samshuanlin/ME210_FinalProject/code/test/README.md

For people who are more familiar with the Arduino IDE, you can store the .ino files here.
