samshuanlin/ME210_FinalProject/schematic/core_mcu.kicad_sch

## KiCad design schematic/core_mcu.kicad_sch (2025-03-10)

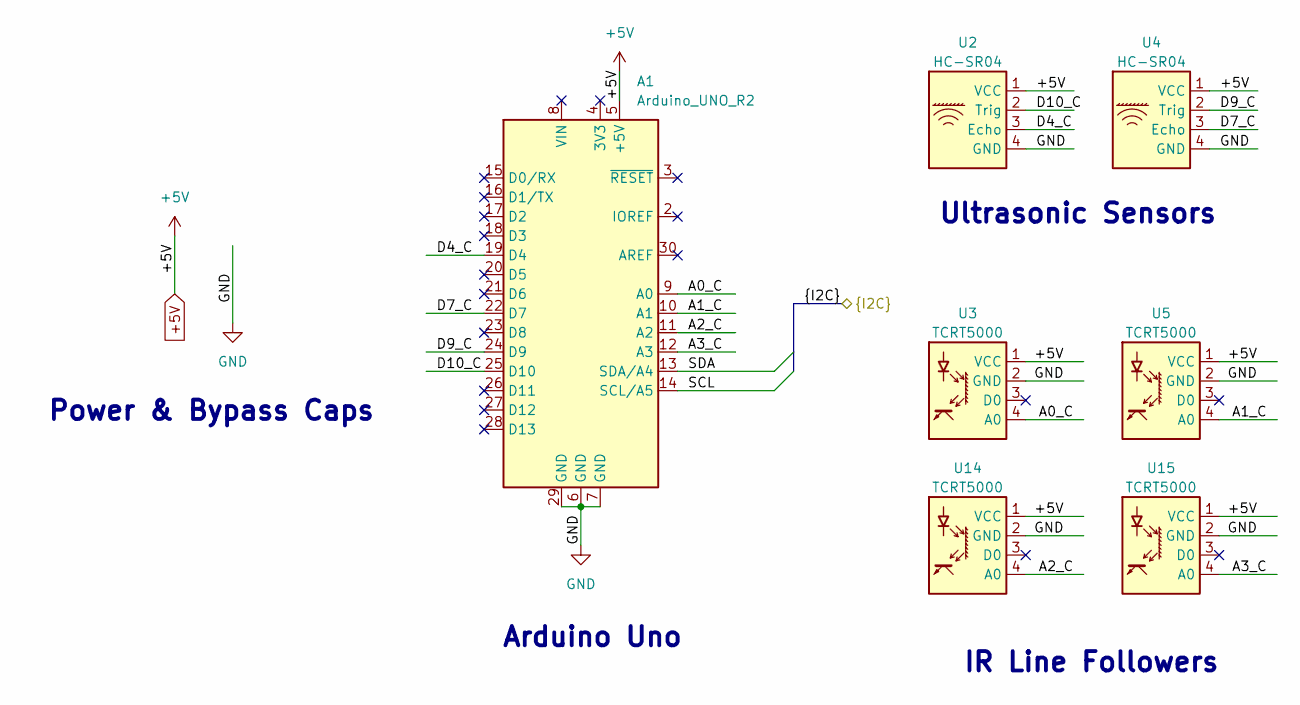
[picture p1: schematic core_mcu.kicad_sch]

Parts:
A1: Arduino_UNO_R2
U2, U4: HC-SR04
U3, U5, U14, U15: TCRT5000

Connections:
+5V: A1.5 (+5V), U2.1 (VCC), U3.1 (VCC), U4.1 (VCC), U5.1 (VCC), U14.1 (VCC), U15.1 (VCC)
A0_C: A1.9 (A0), U3.4 (A0)
A1_C: A1.10 (A1), U5.4 (A0)
A2_C: A1.11 (A2), U14.4 (A0)
A3_C: A1.12 (A3), U15.4 (A0)
D4_C: A1.19 (D4), U2.3 (Echo)
D7_C: A1.22 (D7), U4.3 (Echo)
D9_C: A1.24 (D9), U4.2 (Trig)
D10_C: A1.25 (D10), U2.2 (Trig)
GND: A1.6 (GND), A1.7 (GND), A1.29 (GND), U2.4 (GND), U3.2 (GND), U4.4 (GND), U5.2 (GND), U14.2 (GND), U15.2 (GND)
SCL: A1.14 (SCL/A5)
SDA: A1.13 (SDA/A4)

Notes on the sheet:
IR Line Followers
Ultrasonic Sensors
Power & Bypass Caps
Arduino Uno
