samshuanlin/ME210_FinalProject/schematic/master_mcu.kicad_sch

## KiCad design schematic/master_mcu.kicad_sch (2025-03-10)

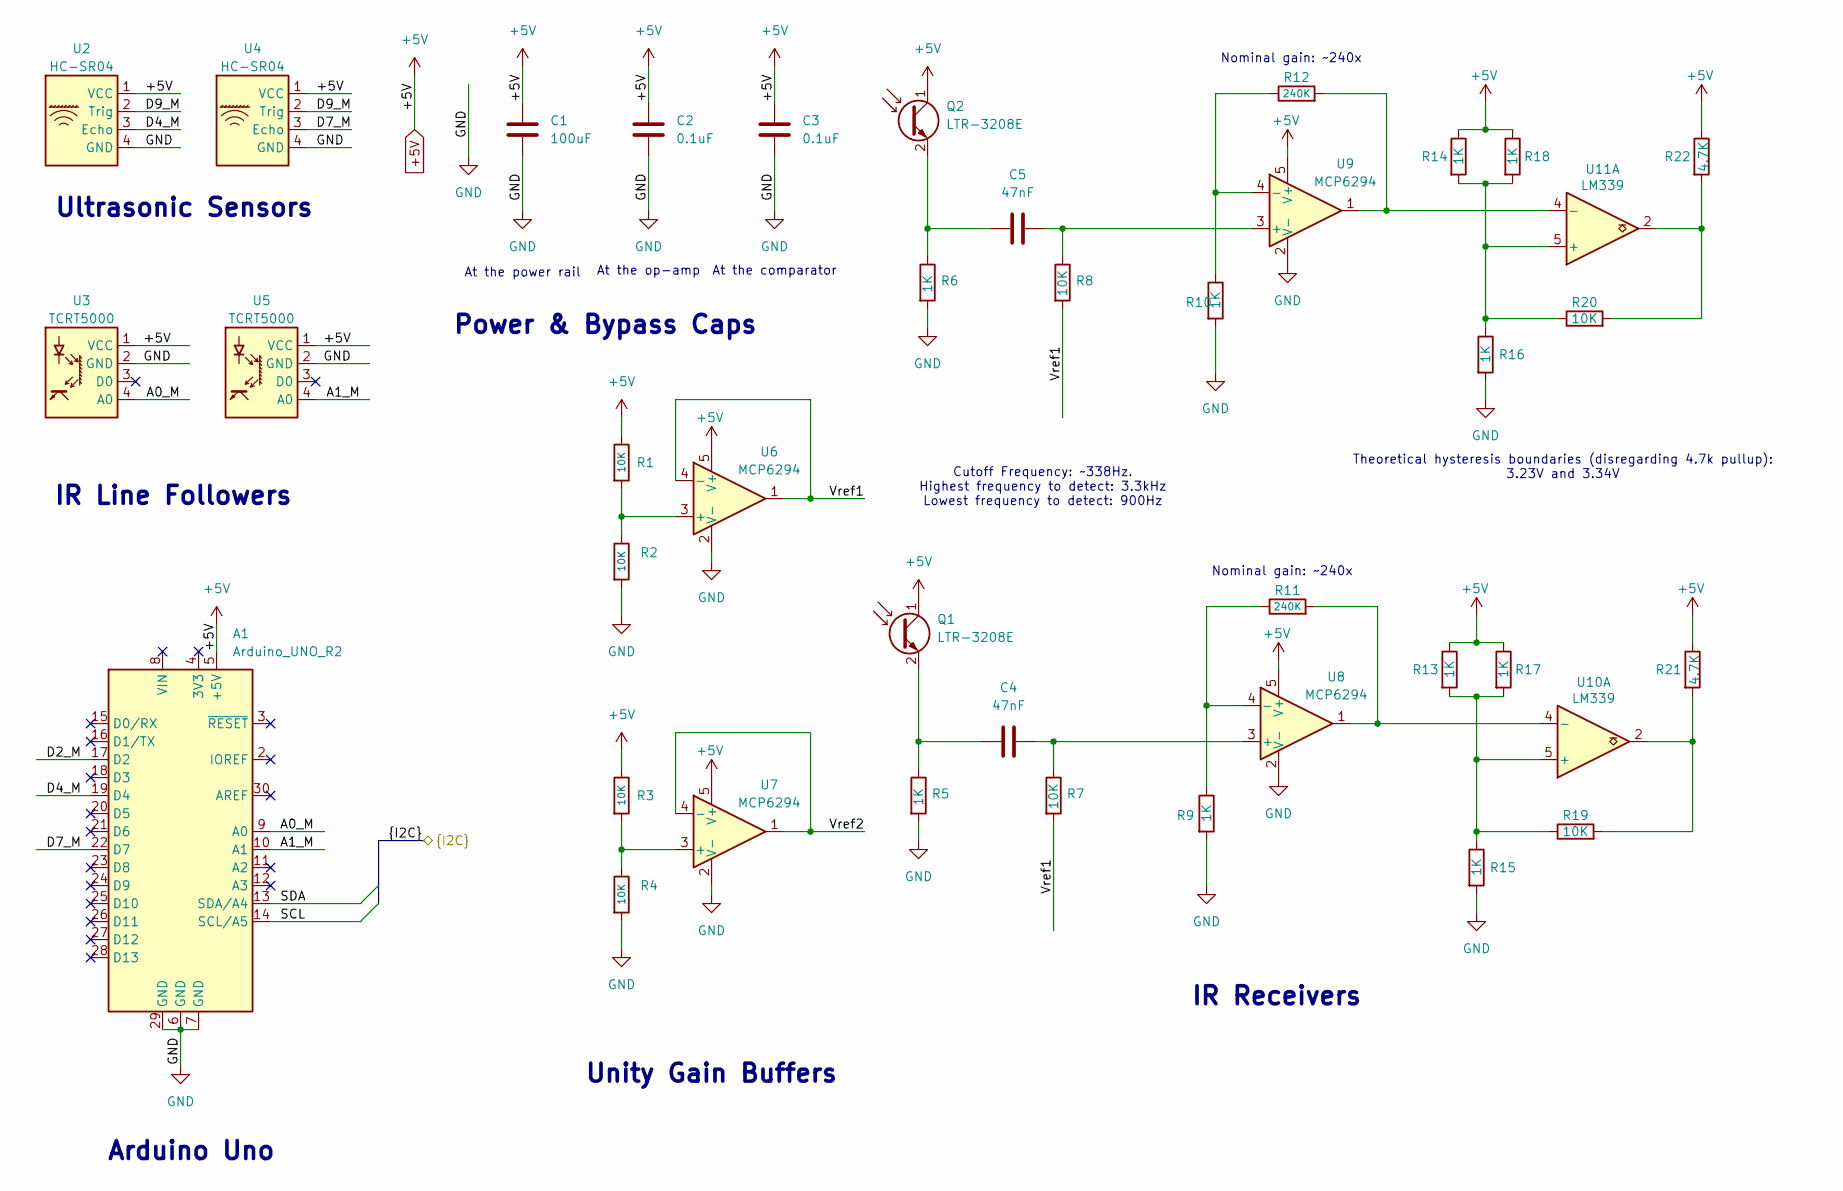
[picture p2: schematic master_mcu.kicad_sch]

Parts:
A1: Arduino_UNO_R2
C1: 100uF
C2, C3: 0.1uF
C4, C5: 47nF
Q1, Q2: LTR-3208E
R1, R2, R3, R4, R7, R8, R19, R20: 10K
R5, R6, R9, R10, R13, R14, R15, R16, R17, R18: 1K
R11, R12: 240K
R21, R22: 4.7K
U2, U4: HC-SR04
U3, U5: TCRT5000
U6, U7, U8, U9: MCP6294; SOT-23-5
U10, U11: LM339

Connections:
+5V: A1.5 (+5V), C1.1, C2.1, C3.1, Q1.1 (C), Q2.1 (C), R1.1, R3.1, R13.1, R14.1, R17.1, R18.1, R21.1, R22.1, U2.1 (VCC), U3.1 (VCC), U4.1 (VCC), U5.1 (VCC), U6.5 (V+), U7.5 (V+), U8.5 (V+), U9.5 (V+)
A0_M: A1.9 (A0), U3.4 (A0)
A1_M: A1.10 (A1), U5.4 (A0)
D2_M: A1.17 (D2)
D4_M: A1.19 (D4), U2.3 (Echo)
D7_M: A1.22 (D7), U4.3 (Echo)
D9_M: U2.2 (Trig), U4.2 (Trig)
GND: A1.6 (GND), A1.7 (GND), A1.29 (GND), C1.2, C2.2, C3.2, R2.2, R4.2, R5.2, R6.2, R9.2, R10.2, R15.2, R16.2, U2.4 (GND), U3.2 (GND), U4.4 (GND), U5.2 (GND), U6.2 (V-), U7.2 (V-), U8.2 (V-), U9.2 (V-)
unnamed: C4.1, Q1.2 (E), R5.1
unnamed: C4.2, R7.1, U8.3 (+)
unnamed: C5.1, Q2.2 (E), R6.1
unnamed: C5.2, R8.1, U9.3 (+)
unnamed: R1.2, R2.1, U6.3 (+)
unnamed: R3.2, R4.1, U7.3 (+)
unnamed: R10.1, R12.1, U9.4 (-)
unnamed: R9.1, R11.1, U8.4 (-)
unnamed: R11.2, U8.1, U10.4 (-)
unnamed: R12.2, U9.1, U11.4 (-)
unnamed: R13.2, R15.1, R17.2, R19.1, U10.5 (+)
unnamed: R14.2, R16.1, R18.2, R20.1, U11.5 (+)
unnamed: R19.2, R21.2, U10.2
unnamed: R20.2, R22.2, U11.2
SCL: A1.14 (SCL/A5)
SDA: A1.13 (SDA/A4)
Vref1: R7.2, R8.2, U6.1, U6.4 (-)
Vref2: U7.1, U7.4 (-)

Notes on the sheet:
At the power rail
At the comparator
IR Line Followers
At the op-amp
Nominal gain: ~240x
Cutoff Frequency: ~338Hz. Highest frequency to detect: 3.3kHz Lowest frequency to detect: 900Hz
Ultrasonic Sensors
Unity Gain Buffers
IR Receivers
Power & Bypass Caps
Arduino Uno
Theoretical hysteresis boundaries (disregarding 4.7k pullup): 3.23V and 3.34V
