samshuanlin/ME210_FinalProject/schematic/peripheral_mcu.kicad_sch

## KiCad design schematic/peripheral_mcu.kicad_sch (2025-03-10)

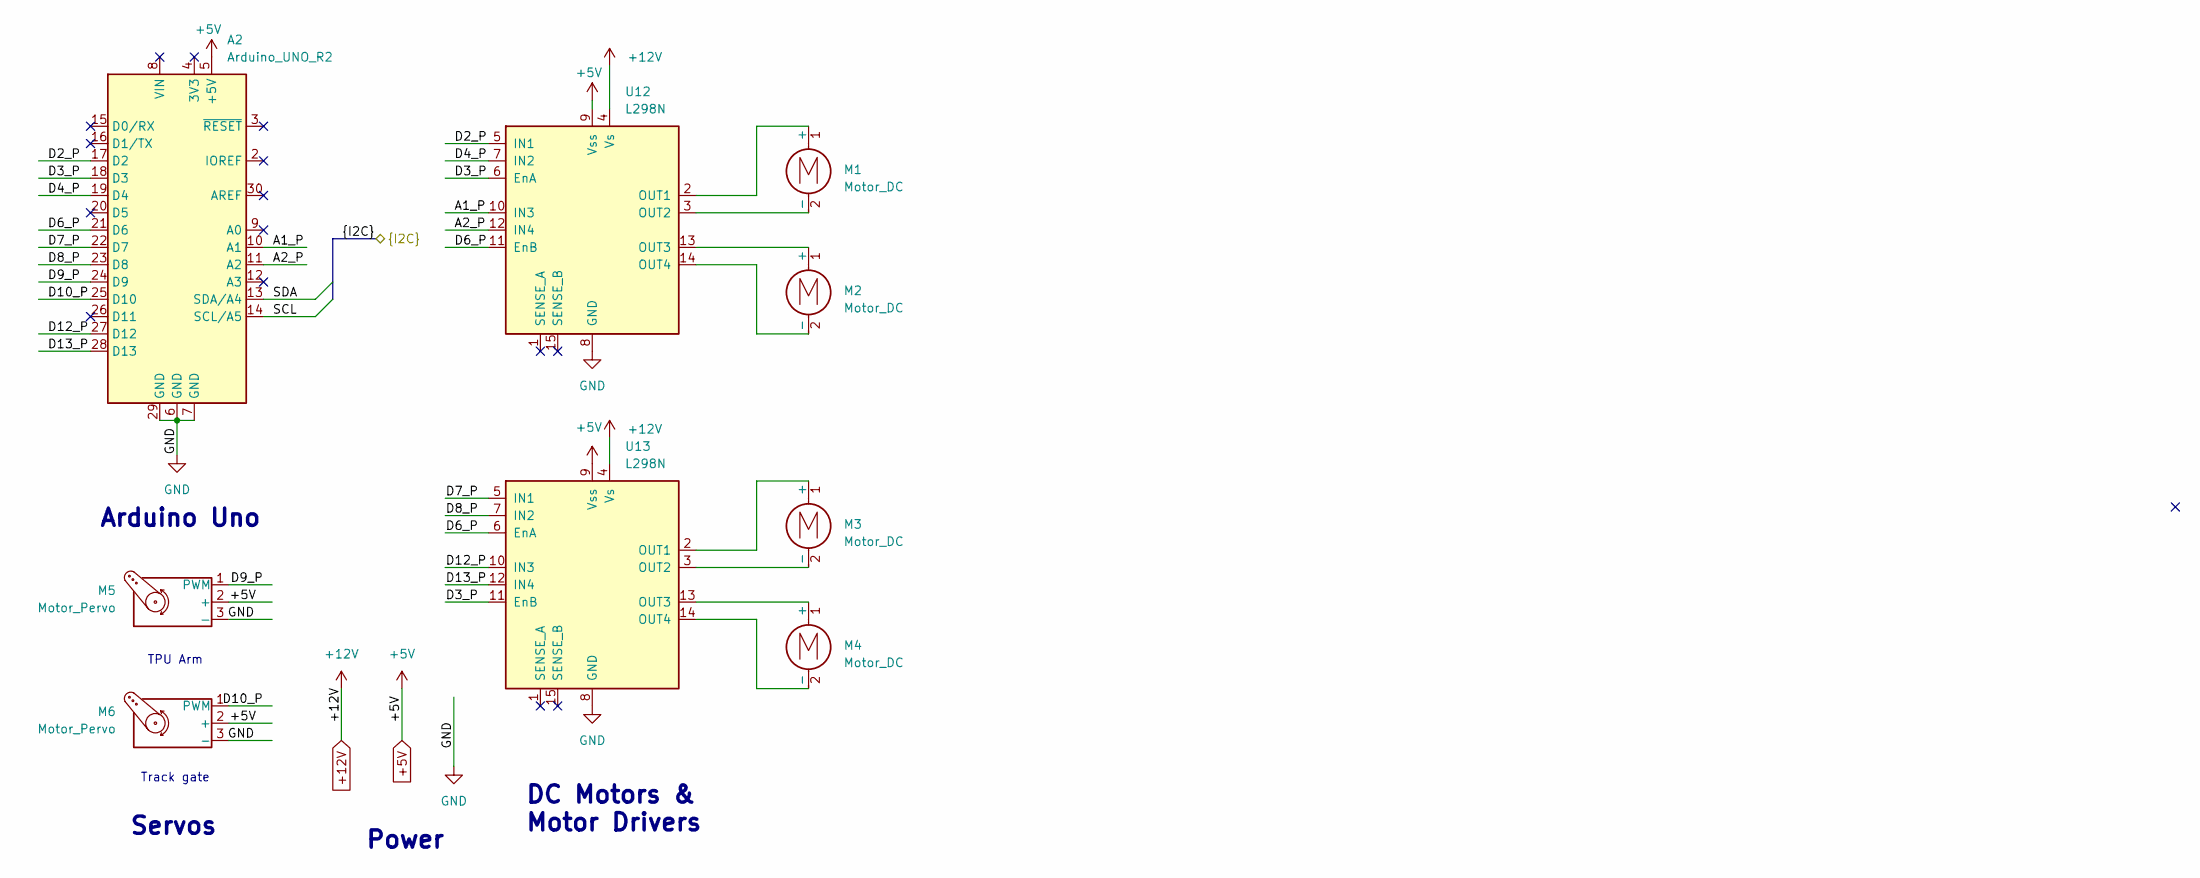
[picture p3: schematic peripheral_mcu.kicad_sch]

Parts:
A2: Arduino_UNO_R2
M1, M2, M3, M4: Motor_DC
M5, M6: Motor_Pervo
U12, U13: L298N; TO-220-15_P2.54x2.54mm_StaggerOdd_Lead4.58mm_Vertical

Connections:
+5V: A2.5 (+5V), M5.2 (+), M6.2 (+), U12.9 (Vss), U13.9 (Vss)
+12V: U12.4 (Vs), U13.4 (Vs)
A1_P: A2.10 (A1), U12.10 (IN3)
A2_P: A2.11 (A2), U12.12 (IN4)
D2_P: A2.17 (D2), U12.5 (IN1)
D3_P: A2.18 (D3), U12.6 (EnA), U13.11 (EnB)
D4_P: A2.19 (D4), U12.7 (IN2)
D6_P: A2.21 (D6), U12.11 (EnB), U13.6 (EnA)
D7_P: A2.22 (D7), U13.5 (IN1)
D8_P: A2.23 (D8), U13.7 (IN2)
D9_P: A2.24 (D9), M5.1 (PWM)
D10_P: A2.25 (D10), M6.1 (PWM)
D12_P: A2.27 (D12), U13.10 (IN3)
D13_P: A2.28 (D13), U13.12 (IN4)
GND: A2.6 (GND), A2.7 (GND), A2.29 (GND), M5.3 (-), M6.3 (-), U12.8 (GND), U13.8 (GND)
unnamed: M1.1 (+), U12.2 (OUT1)
unnamed: M1.2 (-), U12.3 (OUT2)
unnamed: M2.1 (+), U12.13 (OUT3)
unnamed: M2.2 (-), U12.14 (OUT4)
unnamed: M3.1 (+), U13.2 (OUT1)
unnamed: M3.2 (-), U13.3 (OUT2)
unnamed: M4.1 (+), U13.13 (OUT3)
unnamed: M4.2 (-), U13.14 (OUT4)
SCL: A2.14 (SCL/A5)
SDA: A2.13 (SDA/A4)

Notes on the sheet:
Servos
Track gate
DC Motors & Motor Drivers
Arduino Uno
Power
TPU Arm
