samshuanlin/ME210_FinalProject/schematic/schematic.kicad_sch

## KiCad design schematic/schematic.kicad_sch (2025-03-10)

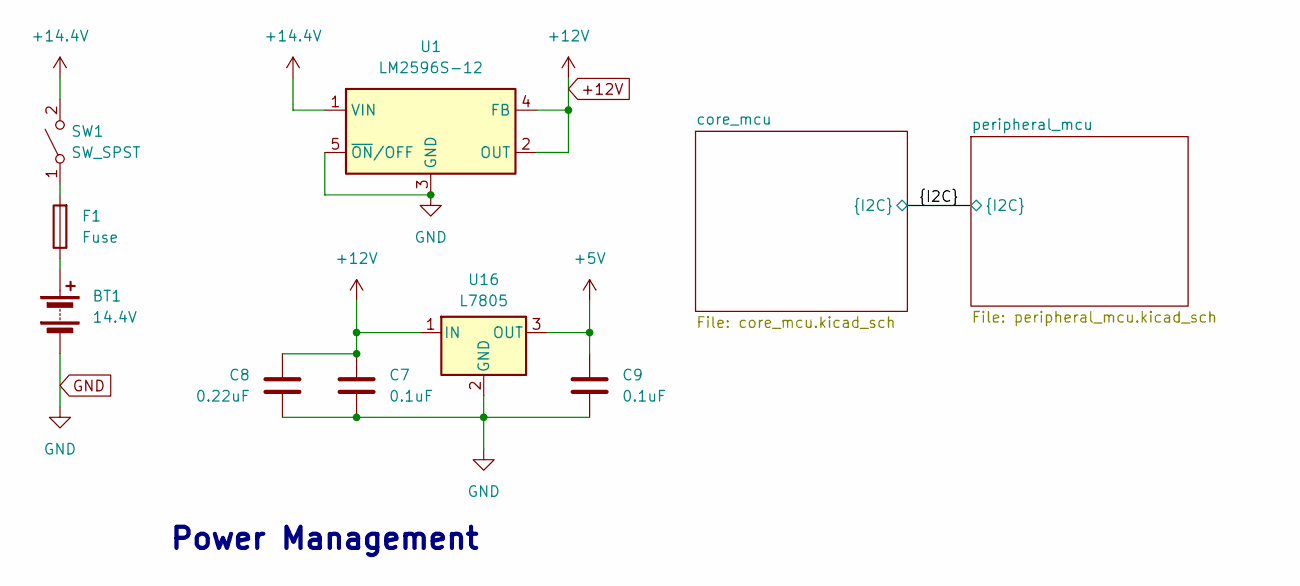
[picture p4: schematic schematic.kicad_sch]

Parts:
BT1: 14.4V
C7, C9: 0.1uF
C8: 0.22uF
F1: Fuse
SW1: SW_SPST
U1: LM2596S-12; TO-263-5_TabPin3
U16: L7805

Connections:
+5V: C9.1, U16.3 (OUT)
+12V: C7.1, C8.2, U1.2 (OUT), U1.4 (FB), U16.1 (IN)
+14.4V: SW1.2 (B), U1.1 (VIN)
GND: BT1.2 (-), C7.2, C8.1, C9.2, U1.3 (GND), U1.5 (~ON/OFF), U16.2 (GND)
unnamed: BT1.1 (+), F1.1
unnamed: F1.2, SW1.1 (A)

Notes on the sheet:
Power Management
