samshuanlin/ME210_FinalProject/code/test/LSM9DS1_calibration.cpp

#include <Arduino.h>
/***************************************************************************
  This is an example for the Adafruit SensorLab library
  It will look for a supported magnetometer and output
  uTesla data as well as the hard iron calibration offsets
  
  Written by Limor Fried for Adafruit Industries.
 ***************************************************************************/

// this is a huge library, so I will only do this when I actually need to calibrate it.
// You should not have to worry about this script.
#include <Adafruit_SensorLab.h> 
 Adafruit_SensorLab lab;
 
 Adafruit_Sensor *mag;
 sensors_event_t mag_event;
 
 sensors_event_t event;
 float min_x, max_x, mid_x;
 float min_y, max_y, mid_y;
 float min_z, max_z, mid_z;
 
 void setup(void) {
   Serial.begin(115200);
   while (!Serial) delay(10);     // will pause Zero, Leonardo, etc until serial console opens
   
   Serial.println(F("Sensor Lab - Magnetometer Calibration!"));
   lab.begin();
   
   Serial.println("Looking for a magnetometer");
   mag = lab.getMagnetometer();
   if (! mag) {
     Serial.println(F("Could not find a magnetometer, check wiring!"));
     while(1) delay(10);
   }
   mag->printSensorDetails();
   delay(100);
 
   mag->getEvent(&event);
   min_x = max_x = event.magnetic.x;
   min_y = max_y = event.magnetic.y;
   min_z = max_z = event.magnetic.z;
   delay(10);
 }
 
 
 
 void loop() {
   mag->getEvent(&event);
   float x = event.magnetic.x;
   float y = event.magnetic.y;
   float z = event.magnetic.z;
   
   Serial.print("Mag: (");
   Serial.print(x); Serial.print(", ");
   Serial.print(y); Serial.print(", ");
   Serial.print(z); Serial.print(")");
 
   min_x = min(min_x, x);
   min_y = min(min_y, y);
   min_z = min(min_z, z);
 
   max_x = max(max_x, x);
   max_y = max(max_y, y);
   max_z = max(max_z, z);
 
   mid_x = (max_x + min_x) / 2;
   mid_y = (max_y + min_y) / 2;
   mid_z = (max_z + min_z) / 2;
   Serial.print(" Hard offset: (");
   Serial.print(mid_x); Serial.print(", ");
   Serial.print(mid_y); Serial.print(", ");
   Serial.print(mid_z); Serial.print(")");  
 
   Serial.print(" Field: (");
   Serial.print((max_x - min_x)/2); Serial.print(", ");
   Serial.print((max_y - min_y)/2); Serial.print(", ");
   Serial.print((max_z - min_z)/2); Serial.println(")");    
   delay(10); 
 }
