samshuanlin/ME210_FinalProject/(commit log)

2025-02-19 setting up magnetometer'
2025-02-20 organizational changes and KiCad file addition
    [schematic.kicad_pcb, schematic.kicad_sch]
2025-02-20 added custom symbols for clarity
    [schematic.kicad_sch]
2025-02-20 schematic first iter. Running out of pins
    [schematic.kicad_sch]
2025-02-21 added to schematic and added line sensor test code
2025-02-21 schematic updated
    [master_mcu.kicad_sch, peripheral_mcu.kicad_sch, schematic.kicad_sch]
2025-02-23 new code for the line sensors
2025-02-24 update schematic
    [peripheral_mcu.kicad_sch]
2025-02-25 updated code for states and line sensors and servo
2025-02-25 added IR and ultrasonic functions
2025-02-25 switched to the PWM servo library, potentially due to implementation of ultrasonic sensing with analogWrite()
2025-02-25 added the new file motor_implementation.ino
2025-02-26 updated schematic
    [master_mcu.kicad_sch, peripheral_mcu.kicad_sch, schematic.kicad_sch]
2025-02-26 update schematics
    [core_mcu.kicad_sch, peripheral_mcu.kicad_sch, schematic.kicad_sch]
2025-02-28 schematic update
    [peripheral_Ccu.kicad_sch, peripheral_mcu.kicad_sch, schematic.kicad_sch]
2025-02-28 minor edits' :
    [peripheral_Ccu.kicad_sch]
2025-03-03 added corrections for the loading state
    [core.cpp, core.h]
2025-03-07 code that fixed ultrasonic sensing
    [RCWL1601_test.cpp, core.cpp, core.h]
2025-03-07 line following, motor speed adjustment
2025-03-07 Modifications explained in the group: correction of us sensing + addition of the new state FIRST_LOADING
    [core.cpp, core.h, peripheral.cpp]
2025-03-09 update schematic to match most recent config
    [core_mcu.kicad_sch, peripheral_mcu.kicad_sch, schematic.kicad_sch]
